kushpet/gnss-fe/README.md

# gnss-fe — смеситель и фильтры к LibreSDR для пары L1/L5

Плата между многочастотной ГНСС-антенной и LibreSDR (AD9363, режим 2R2T): **своя плата v2 (решение 2026-10-28)** — один вход антенны, три выхода, вход гетеродина, вход питания; смеситель переносит L1 на частоту L5 (`docs/03-Плата-v2.md`). Модульный вариант 2026-10-22 (готовые сплиттер и Bias-T, модуль смесителя, фильтры с SMA) — запасной; описание ниже относится к нему. Гетеродин смесителя даёт TX1 того же AD9363, поэтому оба канала когерентны: одна опора, один АЦП, постоянная межканальная задержка. Третий выход сплиттера — HackRF. Смеситель: основной кандидат — модуль HMC213 с AliExpress (пассивный, нужен усилитель гетеродина и МШУ-модуль перед ним), запасной — LTC5510 на своей плате по схеме демоплаты (демоплаты слишком дороги, 2026-10-22).

Узлы — часть исследовательского макета станции ионосферного мониторинга (`~/GitHub/kushpet/iono-gnss`): системные решения, частотный план и конфигурация gnss-sdr — там, в `docs/frontend.md`. Здесь — смеситель и фильтры: требования, компоненты, расчёты, KiCad, измерения.

**Схема A — решение пользователя 2026-10-28**: RX1 — L5 напрямую, RX2 — L1 через фильтр L1 → МШУ SPF5189Z → HMC213 → ФНЧ (`iono-gnss/docs/frontend.md`, разделы 3.8–3.9). Схема B (L1 напрямую, L5 через смеситель) — запасная. Фильтры — готовые модули с SMA с Али; запасной путь — LTCC Mini-Circuits на тестовых платах 1206 с SMA.

```
АНТЕННА ─ кабель ─ Bias-T 5 В ─ сплиттер ─┬─────────────────────────────────────────────────► LibreSDR RX1: L5/E5a/B2a
(МШУ 28–40 дБ)      (готовый)  (готовый)   ├─► ПАВ L1 ─► SPF5189Z ─► HMC213 RF→IF ─► ФНЧ ─────► LibreSDR RX2: L1/E1/B1C
                                           │                            ▲ LO +11…+13 дБм       на 1176.45, спектр инвертирован
                                           │                            └── SPF5189Z ◄── LibreSDR TX1, 2751.87 МГц
                                           └─► третий выход или второй сплиттер в плечо L5 ──► HackRF, во вторую очередь
```

## Состояние

| Этап (нумерация `iono-gnss/docs/frontend.md`) | Что | Статус |
| --- | --- | --- |
| Ф1 | испытания LibreSDR без новых узлов: мощность TX1 на 2.75 ГГц, утечка TX1 в приёмные тракты, паразиты у 1175/1575 МГц, gnss-sdr в 2R2T | не начат |
| Ф3 | схема A (решено 2026-10-28); своя плата v2 — `docs/03-Плата-v2.md` (порты, тракты, бюджет, изготовление, что нужно от пользователя); запасной путь — модуль HMC213 с усилителем гетеродина (или своя плата LTC5510); универсальная плата ПАВ — KiCad, заказ | требования — черновик 2026-10-22 |
| Ф4 | АЧХ узлов петлёй LibreSDR, утечки гетеродина, двухчастотный приём | — |

## Документы

| Файл | Что | Статус |
| --- | --- | --- |
| `docs/01-Требования.md` | состав, плата ПАВ, смеситель, изготовление, открытые вопросы | черновик 2026-10-22 |
| `docs/04-Схема-черновик.md` | черновик схемы платы v2 по блокам: детали, номиналы, выводы, что с ним делать | черновик 2026-10-28 |
| `kicad/` | проект KiCad 10 платы v2 по `docs/04`: листы A–I, свои символы и посадочные места, генератор `kicad/tools/gen_sch.py` | схема-черновик 2026-10-28: нетлист сверен, ERC чистый; разводки нет |
| `docs/03-Плата-v2.md` | своя плата v2: порты, тракты, бюджет шума, LTC5510 или HMC213B, кандидаты, изготовление, этапы | черновик 2026-10-28 |
| `docs/02-Компоненты.md` | демоплаты смесителя, ПАВ, трансформаторы, где купить, что сверить | черновик 2026-10-18, дополнен 2026-10-22 |
| `calc/budget.py` | бюджет шума по трактам (своя плата и готовые модули, схемы A и B), паразитные отклики смесителя | работает: `python3 calc/budget.py` |

**Легенда достоверности** (как в `libresdr-lna`, `qo100-gs`): **[ВД]** паспорт изготовителя · **[ВИ]** вторичный источник (дистрибьютор, карточка магазина) · **[И]** собственное измерение · **[О]** наша оценка или расчёт.
