kushpet/gnss-fe/docs/04-Схема-черновик.md

# Черновик схемы платы v2 (2026-10-28)

Схема по блокам: детали, номиналы, соединения. Основа — `03-Плата-v2.md` и паспорта (LTC5510 rev. A — рис. 1 и 2 и таблицы к ним; BGA524N6 rev. 3.5 — рис. 2, табл. 6; BGA855N6 rev. 2.0 — рис. 2, табл. 6; Mini-Circuits LFCN-1575+, HFCN-2275+). Пометки: [ВД] паспорт, [ВИ] вторичный источник, [О] оценка — подобрать или проверить. Номиналы [О] — предложения, их правим до заказа.

Решения, на которых держится черновик (2026-10-28):

- **Смеситель LTC5510** без усилителя гетеродина: мощность TX1 на 2751.87 МГц около +0.4…+3.4 дБм при полной шкале DDS (`iono-gnss/docs/hardware.md`, «Мощность TX1»), окно LTC5510 −6…+6 дБм [ВД].
- **Питание**: гнездо 5.5 × 2.1 мм, вход 7–12 В (лучше блок 9 В), на плате стабилизаторы 5 В и 2.8 В.
- **Выходы**: OUT1 — L5, OUT2 — L1 на 1176.45 МГц, OUT3 — L2 (ПАВ и МШУ), OUT4 — широкая полоса с делителя (для HackRF на G1, E6/B3, L3OC и для контроля спектра).
- **Сигнальных аттенюаторов нет**; уровни снимает усиление AD9363.

**Проект KiCad** — `kicad/` (2026-10-28): сгенерирован по этому файлу скриптом `kicad/tools/gen_sch.py`, нетлист сверен с задуманными соединениями, ERC — 0 нарушений. Проверено только по паспортам и нетлисту, не в железе. Обозначения ниже совпадают со схемой; поправки 2026-10-28 по паспортам — R6, T2 (C26–C28), FL2.

## Блок A. Питание

| Поз. | Деталь | Номинал, корпус | Соединения | Примечание |
| --- | --- | --- | --- | --- |
| J1 | гнездо питания KLS1-DC-005A-2.0 (Chip-Dip) | на плату, DIP; 30 В 1 А, 5000 циклов, −30…+70 °C [ВД] | вывод 4 — центральный штырь, VIN_RAW (+); 3 — гильза, GND; 2 — переключатель, GND или не подключать | штырь 2.0 мм — под штекеры 5.5 × 2.1 [О]; блок питания с плюсом в центре. Посадочное — своё по чертежу KLS: прорези 3.4 × 0.8 мм под выводы 3 и 4 (через 6 мм по оси), 3.0 × 0.8 мм под вывод 2 (2.5 мм к передней кромке от вывода 4 и 4.8 мм вбок). `BarrelJack_Horizontal` из KiCad почти совпадает, но третий вывод у него сдвинут на 0.5 мм. Центр гнезда — 6.5 мм над платой: отверстие в панели корпуса — на этой высоте |
| D1 | диод Шоттки | 1–3 А, SMA/SMB (класс SS14…SS34) | VIN_RAW → VIN | защита от переполюсовки, падение ~0.4 В [О] |
| F1 | самовосстанавливающийся предохранитель | 0.5 А, 1206 | последовательно с D1 | по желанию [О] |
| U1 | стабилизатор 5 В | ≥ 300 мА, вход до 15 В; кандидаты LM1117-5.0, AMS1117-5.0 или малошумящий | VIN → +5V | с 9 В рассеивает ~0.6 Вт: площадка с медью [О] |
| C1, C2 | 10 мкФ | 0805 | VIN–GND, +5V–GND | по паспорту выбранного U1 |
| FB1, C3, C4 | феррит 600 Ом/100 МГц, 10 мкФ, 100 нФ | 0603, 0805, 0402 | +5V → +5V_MIX | питание LTC5510 |
| FB2, C5, C6 | то же | | +5V → +5V_ANT_IN | питание антенны |
| U2 | малошумящий стабилизатор 2.8 В | ≥ 50 мА; кандидат LP5907MFX-2.8 (есть в библиотеке KiCad) | +5V → +2V8 | МШУ: BGA524N6 1.5–3.3 В, BGA855N6 1.1–3.3 В [ВД] |
| C7, C8 | 1 мкФ | 0402 | вход и выход U2 | по паспорту U2 |
| LED1, R1 | светодиод, 1 кОм | 0603 | +5V–GND | «питание» |

## Блок B. Вход антенны и Bias-T

| Поз. | Деталь | Номинал, корпус | Соединения | Примечание |
| --- | --- | --- | --- | --- |
| J2 | SMA-гнездо торцевое | класс Molex 73251 / Amphenol 132289 (есть в KiCad) | ANT | |
| D2 | защита от статики | ёмкость ≤ 0.3 пФ, рабочее ≥ 5.5 В | ANT–GND | подобрать [О] |
| L1 | дроссель Bias-T | проволочный 0402/0603, 39–56 нГн, резонанс выше 2 ГГц | ANT → ANT_DC | импеданс ≥ 300 Ом на 1.1–1.7 ГГц — сверить по графику [О] |
| C9, C10 | 100 пФ C0G, 10 нФ | 0402 | ANT_DC–GND | развязка по ВЧ со стороны питания |
| U3 | ограничитель тока с флагом аварии | TPS2553DBV, SOT-23-6: 1 IN, 2 GND, 3 EN (активный высокий), 4 ~FAULT (открытый сток), 5 ILIM, 6 OUT [ВД, SLVS841F] | +5V_ANT_IN → ANT_DC; EN — к IN | антенна 15–45 мА; при КЗ в кабеле — ограничение и LED2 |
| R8 | R_ILIM | 210 кОм 1 %, 0402 | ILIM–GND | порог 110/130/150 мА (мин/тип/макс) [ВД, SLVS841F, табл. IOS]; допустимо 15–232 кОм |
| LED2, R2 | светодиод, 1 кОм | 0603 | +5V_ANT_IN → R2 → LED2 → ~FAULT U3 | «авария антенны»: горит, когда U3 тянет флаг к земле |
| C11 | 100 пФ C0G | 0402 | ANT → DIV_IN | разделительный; около 1 ГГц такой конденсатор близок к последовательному резонансу и почти не мешает [О] |
| TP1 | контрольная точка | | ANT_DC | напряжение на антенне |

## Блок C. Делитель 1:2 + 1:2

Три делителя Уилкинсона: DIV_IN → (A, B); A → (P1, P2); B → (P3, P4). Плечи — четвертьволновые линии 70.7 Ом на ~1.38 ГГц (середина 1.17–1.61 ГГц), развязывающий резистор 100 Ом между выходами каждого делителя. На FR4 четверть волны — порядка 30 мм, линии сворачиваются. Геометрию считать в HFSS или openEMS под стек выбранной фабрики [О].

| Поз. | Деталь | Номинал | Примечание |
| --- | --- | --- | --- |
| DIV1, DIV2, DIV3 | делитель Уилкинсона | символ с тремя выводами (IN, O1, O2) | на плате — медь; посадочное место (net tie с геометрией из HFSS/openEMS) пока не назначено |
| R3, R4, R5 | резистор | 100 Ом, 0402, 1 % | по одному на делитель, между O1 и O2 |

Плечи: P1 — тракт L5 (блок D), P2 — тракт L1 (блок E), P3 — тракт L2 (блок F), P4 — OUT4 (блок G). P1 и P2 — с одного делителя, чтобы тракты ядра были симметричны.

## Блок D. Тракт L5 → OUT1

| Поз. | Деталь | Номинал, корпус | Соединения | Примечание |
| --- | --- | --- | --- | --- |
| R9 | перемычка | 0 Ом, 0402 | P1 → L5_IN | мерить узлы по отдельности |
| FL1 | ПАВ L5 | Huaying NDFH059-1176SA (1.1 × 0.9 мм, LCSC C5158023): потери ≤ 1.6 дБ в 1166–1187 МГц; 1 — вход, 4 — выход, 2, 3, 5 — земля [ВД]; запасные Qorvo QPQ1062, Abracon AFII-SW-0060 | L5_IN → L5_SAW | рекомендованного посадочного в паспорте нет — своё по чертежу корпуса, сверить [О]; земли — переходными отверстиями прямо у площадок |
| L2 | индуктивность согласования | 9.4 нГн, 0402, Murata LQW15 | L5_SAW → AI (5) U4 | [ВД, BGA855N6, табл. 6] |
| U4 | BGA855N6 | TSNP-6-10 | 1, 4 — GND; 2 — +2V8; 3 — AO → L5_LNA; 5 — AI; 6 — PON → +2V8 | [ВД] |
| C12 | ≥ 1 нФ | 0402 | +2V8–GND у вывода 2 | ВЧ-развязка [ВД] |
| C13 | 100 пФ C0G | 0402 | L5_LNA → J3 | разделительный [О] |
| J3 | SMA торцевое | | OUT1 → LibreSDR RX1 | |

Разделительный 1 нФ на входе МШУ (C1 в паспорте) не нужен: постоянный ток не проходит через ПАВ [ВД, сноска к табл. 6 BGA524N6].

## Блок E. Тракт L1 → смеситель → OUT2

| Поз. | Деталь | Номинал, корпус | Соединения | Примечание |
| --- | --- | --- | --- | --- |
| R10 | перемычка | 0 Ом, 0402 | P2 → L1_IN | мерить узлы по отдельности |
| FL2 | ПАВ L1 широкий | нужно: полоса не уже 1563–1588 МГц, ≥ 30 дБ на 1164–1189 МГц. В схеме — Huaying NDFH003-1580SA (LCSC C312141): потери ≤ 1.6–2.1 дБ в 1559–1606 МГц, выводы как у FL1 [ВД]; запасной Murata SAFFB1G56KB0F0A (1559–1606) | L1_IN → L1_SAW | **подавление NDFH003 в 960–1427 МГц, то есть на L5, в паспорте не задано**: таблица — ≥ 45 дБ до 925 МГц и ≥ 41 дБ в 1427–1453 МГц, график — только 1455–1705 МГц. Замерить петлёй до заказа плат [О] |
| L3 | индуктивность согласования | 8.2 нГн, 0402, Murata LQW | L1_SAW → AI (5) U5 | [ВД, BGA524N6, табл. 6] |
| U5 | BGA524N6 | TSNP-6-10 | 1, 4 — GND; 2 — +2V8; 3 — AO → L1_LNA; 5 — AI; 6 — PON → +2V8 | [ВД] |
| C14 | 1 мкФ (≥ 10 нФ) | 0402 | +2V8–GND у вывода 2 | [ВД] |
| R11 | перемычка | 0 Ом, 0402 | L1_LNA → MIX_IN (T1) | мерить МШУ и смеситель по отдельности |
| U6 | LTC5510 | QFN-16 4 × 4 мм (UF16), шаг 0.65 мм, площадка снизу 2.15 × 2.15 мм — земля [ВД, стр. 28]; посадочное `QFN-16-1EP_4x4mm_P0.65mm_EP2.15x2.15mm_ThermalVias` из KiCad | см. ниже | [ВД] |
| FL3 | ФНЧ LFCN-1575+ | FV1206 | IF_OUT → IF_LPF | DC–1575 МГц, 37 дБ на 2700 МГц [ВД] |
| C15 | 100 пФ C0G | 0402 | IF_LPF → J4 | |
| J4 | SMA торцевое | | OUT2 → LibreSDR RX2 | |

Выводы U6 [ВД, паспорт LTC5510, Pin Functions] и обвязка:

| Вывод | Куда | Детали |
| --- | --- | --- |
| 1 TEMP | контрольная точка TP2 | диод на кристалле через 30 Ом — по нему можно мерить температуру смесителя (уход DCB) |
| 2 IN+, 3 IN− | вторичная обмотка T1 через C16, C17 | T1 — TC1-1-13M+ (1:1), первичная — L1_LNA и земля; C16, C17 — 0.1 мкФ 0402; C18 — 0.7 пФ C0G на входе, как на DC1983A (рис. 1) |
| 4 LGND | GND через L4 | L4 — 0 Ом 0603 (рис. 1); ток ~64 мА |
| 5 EN | +5V_MIX | включено при > 1.8 В |
| 6, 7 VCC1, VCC2 | +5V_MIX | C19 — 10 нФ у выводов, C20 — 1 мкФ 0603 |
| 8 IADJ | R6 не ставится | **поправка 2026-10-28**: по табл. 7 паспорта при 5 В и fOUT < 1200 МГц IADJ открыт (ICC 105 мА); 4.75 кОм — для fOUT > 1200 МГц. На DC1984A R1 тоже не стоит [ВД]. Место R6 (0402 на GND) оставлено для подбора |
| 9, 12, 13, 17 GND | земля | площадка снизу — много переходных отверстий |
| 10 OUT−, 11 OUT+ | T2 — TC4-19LN+ (4:1), AT224-1A | по рис. 2 (DC1984A) [ВД]: OUT+ → L5 15 нГн → T2 вывод 3, OUT− → L6 15 нГн → T2 вывод 1 (вторичная, 200 Ом); средний отвод T2 (вывод 2) — к +5V_MIX, C26 10 нФ у вывода (C8 на DC1984A); питание выходов ~32 мА на вывод. Первичная: вывод 6 → C27 10 нФ → FL3, вывод 4 → C28 10 нФ → земля — у TC4-19LN+ обмотки соединены по постоянному току, на обоих концах первичной нужны разделительные конденсаторы [ВД, паспорт TC4-19LN+]. Вывода 5 у TC4-19LN+ нет |
| 14 LO− | GND через C21 | C21 — 0.1 мкФ 0402: гетеродин несимметричный |
| 15 LO+ | от блока H через C22 | C22 — 0.1 мкФ 0402 |
| 16 TP | GND | обязательно [ВД] |

**Главный риск схемы**: выход на 1176 МГц. DC1984A в паспорте охарактеризована с выходом 100–1000 МГц, а DC1983A — с выходом 1575 МГц (балун BD1222J50200AHF, 6.8 нГн × 2, 6.8 пФ). 1176 МГц лежит между ними. Выход LTC5510 — 201 Ом || 0.6 пФ дифференциально на 1500 МГц [ВД]; 0.6 пФ на 1176 МГц — 225 Ом, то есть ёмкость уже сравнима с нагрузкой. Предложение [О]: обвязка DC1984A (TC4-19LN+, L5 и L6 по 15 нГн) и места под подбор:
- **L8, L9** (0603, не ставятся) — от OUT+ и OUT− к +5V_MIX, как L1 и L2 на DC1984A. Резонанс с 0.6 пФ на 1176 МГц даёт ~30 нГн дифференциально, то есть ~15 нГн на плечо [О];
- **C29** (0402, не ставится) — параллельно первичной обмотке T2;
- **L5, L6** — 0402, номинал подбирается.

Подбирать по максимуму S21 петлёй LibreSDR на 1176 МГц.

## Блок F. Тракт L2 → OUT3

| Поз. | Деталь | Номинал, корпус | Соединения | Примечание |
| --- | --- | --- | --- | --- |
| FL4 | ПАВ L2 | кандидаты Qorvo QPQ1061 (1227.6 МГц, 31 МГц, 1.4 × 1.2 мм), Microchip TFS1227K (24 МГц, 1.4 × 1.1 мм) | P3 → L2_SAW | ГЛОНАСС G2 (1243–1249 МГц) у найденных не покрыт или покрыт краем; G2 — через OUT4 [ВИ] |
| L7, U7, C23 | как L2, U4, C12 в блоке D | BGA855N6 работает на 1164–1300 МГц [ВД] | L2_SAW → U7 → L2_LNA | |
| C24 | 100 пФ C0G | 0402 | L2_LNA → J5 | **обязателен**: HackRF может подать на порт 3.3 В |
| J5 | SMA торцевое | | OUT3 → HackRF | |

## Блок G. OUT4 — широкая полоса

| Поз. | Деталь | Номинал | Соединения | Примечание |
| --- | --- | --- | --- | --- |
| C25 | 100 пФ C0G | 0402 | P4 → OUT4 | разделительный |
| J6 | SMA торцевое | | OUT4 | |
| R7 | 49.9 Ом | 0402, по желанию | P4–GND | ставится вместо J6, если выход не нужен; неподключённый выход закрывать нагрузкой 50 Ом |

## Блок H. Гетеродин

| Поз. | Деталь | Номинал, корпус | Соединения | Примечание |
| --- | --- | --- | --- | --- |
| J7 | SMA торцевое | | LO ← LibreSDR TX1 | |
| FL5 | ФВЧ HFCN-2275+ | FV1206: 1 — вход, 3 — выход, 2, 4 — земля [ВД] | J7 → LO_HPF → C22 → LO+ U6 | давит шум TX в L-диапазоне: ≥ 40 дБ (тип. 45) на 1400 МГц [ВД] |

Уровень гетеродина задаётся программно (`lo_attenuation_db` в gnss-sdr); при оценке TX1 +0.4…+3.4 дБм и потерях ФВЧ ~1 дБ — начать с 0 дБ.

## Блок I. Конструкция

- Экран-рамка SH1 на плате над U6, T1, T2 и трактом гетеродина. В схеме стоит Laird BMI-S-203-F (26 × 26 мм) из `RF_Shielding`; размер подобрать по разводке [О].
- Плата — 4 слоя, 1.6 мм; второй слой — сплошная земля; копланарные линии 50 Ом с землёй; переходные отверстия вдоль линий и у земляных площадок ПАВ и МШУ.
- Все SMA — торцевые, на двух кромках: ANT, LO и питание — на одной, OUT1–OUT4 — на другой.
- Последовательные 0 Ом между блоками C–D (R9), C–E (R10), E (U5 → T1, R11), чтобы мерить узлы по отдельности.

## Проект KiCad (`kicad/`)

| Файл | Что |
| --- | --- |
| `gnss-fe.kicad_pro`, `gnss-fe.kicad_sch` | проект и корневой лист — структура платы |
| `A_power` … `I_mech.kicad_sch` | листы блоков A–I этого файла |
| `gnss-fe.kicad_sym` | свои символы: LTC5510, BGA524N6, BGA855N6, ПАВ (5 выводов, нумерация Huaying), HFCN-2275+, TC4-19LN+, TPS2553DBV, KLS1-DC-005A, делитель Уилкинсона, экран, цепи +5V_MIX и +5V_ANT_IN |
| `gnss-fe.pretty` | свои посадочные: TSNP-6-10 (рис. 6–7 паспорта BGA524N6 [ВД]), ПАВ Huaying 1.1 × 0.9 мм (по чертежу корпуса [О]), KLS1-DC-005A (по чертежу KLS [ВД], кольцо площадок [О]) |
| `tools/gen_sch.py`, `kisch.py`, `gen_lib.py` | генератор: `python3 kicad/tools/gen_sch.py --force`; после правок в KiCad не запускать — перезапишет |

Не назначены посадочные: DIV1–DIV3 (медь делителя — после расчёта под стек) и FL4 (ПАВ L2 не выбран). Перед разводкой у FL4 сверить нумерацию выводов. ERC в KiCad чистый, если в KiCad настроены стандартные библиотеки.

## Что с этим делать

1. **Открыть `kicad/gnss-fe.kicad_pro` и прочитать листы.** Всё, что не нравится или непонятно, — сюда, в этот файл или вопросом.
2. **Решить по открытым пунктам**: ПАВ L1 (подавление NDFH003 на L5 не нормировано), ПАВ L2, D2, U1 и его выходной конденсатор, L1, размер экрана.
3. **Параллельно**: выбрать продавца плат на Али и спросить у него стек 4-слойной платы 1.6 мм (толщины слоёв и εr). Под этот стек — ширина линий 50 и 70.7 Ом и модель делителя в HFSS.
4. **Потом** — BOM с источниками (Chip-Dip, Али, LCSC) и ценой, разводка.
