kushpet/gnss-fe/correspondence/rezonit/2026-11-08-письмо.md

# Письмо в Резонит — стек и заказ прототипа

- **Дата:** 2026-11-08
- **Кому:** pcb@rezonit.ru (ООО «Резонит», 8 800 777-80-80)
- **Статус:** отправлено 2026-11-08

> Внимание: правильный домен — **rezonit.ru** (буква z). Если письмо ушло на
> «resonit.ru» — это опечатка, отправить повторно на pcb@rezonit.ru.

---

Здравствуйте.

Разрабатываю прототип СВЧ-платы (фронтенд ГНСС-приёмника, рабочая полоса
~1,1–1,6 ГГц) и хочу заказать у вас плату с трафаретом:

— 4 слоя, толщина 1,6 мм, FR4;
— размер ~100 × 80 мм;
— 5 шт. + трафарет;
— управляемое сопротивление: копланарные линии 50 Ом, плечи делителя 70,7 Ом.

Вопросы:

1. Какой у вас стандартный стек 4-слойной платы 1,6 мм? Нужны точные толщины
   препрегов и ядра, толщина меди и диэлектрическая проницаемость εr (и её
   допуск) — по ним я посчитаю ширину линий 50 и 70,7 Ом. Если есть готовый
   стек под управляемое сопротивление — пришлите, пожалуйста.

2. Принимаете ли Gerber RS-274X + Excellon (экспорт из KiCad)? Есть ли
   требования к именам файлов, контуру, панелизации?

3. Какая цена и срок на 5 шт. (4 слоя, 100 × 80 мм) + трафарет?

4. Есть ли онлайн-калькулятор импеданса или тестовый купон для контроля 50 Ом?

Заранее спасибо.
