kushpet/gnss-fe/docs/03-Плата-v2.md

# Плата v2: один вход, три выхода (решение 2026-10-28)

Решение пользователя 2026-10-28: вместо россыпи модулей на столе — своя плата в корпусе. Один вход антенны, три выхода, вход гетеродина и вход питания. Срок не горит: разработка постепенно, сборка, возможно, на рабочем месте. Схема каналов — A (решение 2026-10-28, `iono-gnss/docs/frontend.md`, раздел 3.8). За основу взят черновик 2026-10-18 (в истории git, `ec24c67:docs/01-Требования.md`). Пометки: [ВД] паспорт, [ВИ] вторичный источник, [И] измерение, [О] оценка.

## 1. Порты

| Порт | Куда | Сигнал | Требования |
| --- | --- | --- | --- |
| ANT | антенна с МШУ 28–40 дБ, кабель ~5 м | 1164–1610 МГц | SMA-гнездо; Bias-T 5 В с ограничением тока и индикацией; защита от статики малой ёмкости |
| OUT1 | LibreSDR RX1, RX-гетеродин 1176.45 МГц | L5/E5a/B2a | разделительный конденсатор |
| OUT2 | LibreSDR RX2 | L1/E1/B1C, перенесённый на 1176.45 МГц, спектр инвертирован | то же |
| OUT3 | HackRF | L2 (GPS L2C; ПАВ и МШУ) — «полный вариант», ответ 2026-10-28 | разделительный конденсатор обязателен: HackRF может подать на порт 3.3 В |
| OUT4 | HackRF или контроль спектра | широкая полоса с делителя: ГЛОНАСС G1 и G2, E6/B3, L3OC | SMA; неподключённый — закрыть нагрузкой 50 Ом |
| LO | LibreSDR TX1 | 2751.87 МГц, тон DDS | ФВЧ против шума TX в L-диапазоне; уровень — программно (`lo_attenuation_db`) |
| PWR | 7–12 В, гнездо 5.5 × 2.1 мм (ответ 2026-10-28; блок 9 В) | — | ~200 мА [О]; защита от переполюсовки; стабилизаторы 5 В и 2.8 В, LC-фильтры |

## 2. Тракты (схема A)

```
ANT ─ Bias-T, защита ─ делитель 1:2 + 1:2 ─┬─ ПАВ L5 ─ МШУ L5 ─────────────────────────── OUT1 → LibreSDR RX1
                                           ├─ ПАВ L1 ─ МШУ L1 ─ смеситель RF→IF ─ ФНЧ ──── OUT2 → LibreSDR RX2
                                           │                         ▲ LO
                                           │            LO (SMA) ─ ФВЧ (с LTC5510 усилитель гетеродина не нужен)
                                           ├─ ПАВ L2 ─ МШУ L2 ──────────────────────────── OUT3 → HackRF
                                           └─ OUT4: широкая полоса (или нагрузка 50 Ом)
```

Бюджет шума [О, `calc/budget.py`, блок «Своя плата v2»; кабель 5 м RG58]:

| Тракт | Потеря C/N0, антенна 28 / 40 дБ | Усиление до LibreSDR | Шум тракта над шумом LibreSDR |
| --- | --- | --- | --- |
| OUT1: ПАВ L5, BGA855N6 | 0.1 / 0.0 дБ | 34 / 46 дБ | +27 / +39 дБ |
| OUT2: ПАВ L1, BGA524N6, LTC5510, ФНЧ | 0.2 / 0.0 дБ | 36 / 48 дБ | +29 / +40 дБ |
| OUT2: ПАВ L1, BGA524N6, HMC213B, ФНЧ | 0.2 / 0.0 дБ | 24 / 36 дБ | +17 / +29 дБ |

- **Усилители на плате делают тракт независимым от антенны**: при 28 и при 40 дБ потери не больше 0.2 дБ. Делитель 1:2 + 1:2 (~7 дБ) стоит до усилителей и почти ничего не стоит по шуму.
- **Аттенюаторов в сигнальных трактах нет.** Лишнее усиление снимает усиление самого AD9363; шум тракта на 17–40 дБ выше собственного шума LibreSDR, и его паразиты тонут.
- **ПАВ — до усилителя платы**: широкополосный усилитель без фильтра не ставим.
- После HMC213B усилитель ПЧ не нужен: без него потеря 0.2 дБ.
- **Экран-рамка** над смесителем и трактом гетеродина; плата — в алюминиевом корпусе.
- По желанию — датчик температуры рядом с трактами: уход разности задержек L1/L5 даёт уход DCB приёмника.

## 3. Смеситель: LTC5510 или HMC213B

| | LTC5510 | HMC213B |
| --- | --- | --- |
| Тип | активный, 5 В, ~100 мА [ВД] | пассивный, диоды Шоттки, без питания [ВД] |
| Гетеродин | −6…+6 дБм — прямо от TX1 [ВД] | +9…+15 дБм — нужен усилитель гетеродина на плате [ВД] |
| Обвязка | трансформаторы на входе и выходе: TC1-1-13M+ и TC4-19LN+ с 15 нГн × 2, как на DC1984A; выход 10–1300 МГц, на 1176 МГц не характеризован [ВД] | порты 50 Ом, согласование не нужно; IF открыт по постоянному току [ВД] |
| Развязки | лучше: утечка гетеродина на выход < −33 дБм, вход → выход > 22 дБ [ВД] | утечки гетеродина −17…−19 дБм с портов, RF → IF 13 дБ [ВД] |
| Корпус | QFN-16 4 × 4 мм с площадкой — паста и фен или фабрика | MSOP-8 — паяльником |
| LCSC (снимки страниц, 2026-10-28) [ВИ] | LTC5510IUF#PBF C459909: 22 шт., ~$23 | HMC213BMS8E C3191301: нет на складе, ~$20 |

**Решено 2026-10-28 по замеру: LTC5510** без усилителя гетеродина. TX1 на 2751.87 МГц даёт около +0.4…+3.4 дБм при полной шкале DDS (±3 дБ; `iono-gnss/docs/hardware.md`, «Мощность TX1») — в окне LTC5510 −6…+6 дБм. HMC213B — запасной путь (нужен усилитель гетеродина на ~12 дБ).

## 4. Компоненты-кандидаты

Сверить паспорта и наличие при составлении BOM. Подробнее — `02-Компоненты.md`.

| Узел | Кандидаты |
| --- | --- |
| МШУ L1 | Infineon BGA524N6: 1550–1615 МГц, 19.6 дБ, Кш 0.73 дБ на 2.8 В (плата Infineon), LCSC C6752883 [ВИ] |
| МШУ L5 и OUT3 | Infineon BGA855N6: 1164–1300 МГц, 17.8 дБ, Кш 0.6 дБ [ВД]; для OUT3 на L1/G1 — BGA524N6 |
| ПАВ L1/G1 | Murata SAFFB1G56KB0F0A (1559–1606 МГц) [ВИ]; Qualcomm B39162B4300F210 — LCSC C2650962, полосу проверить: в семействе B39162 есть фильтры на 2 МГц, только для C/A [ВИ] |
| ПАВ L5 | Huaying NDFH059-1176SA (LCSC C5158023), Qorvo QPQ1062, Abracon AFII-SW-0060 [ВИ] |
| ФНЧ после смесителя | Mini-Circuits LFCN-1575+ или LFCG-1575+ (LCSC C4989936) [ВД, ВИ] |
| ФВЧ гетеродина | Mini-Circuits HFCN-2275+ [ВД] |
| Делитель | Уилкинсон на линиях 1:2 + 1:2, моделирование в HFSS или openEMS; запасной путь — готовый делитель в корпусе (не искали) |
| Bias-T, питание | дроссель с резонансом выше 2 ГГц, ограничитель тока антенны с флагом аварии, стабилизатор 3.3 В для МШУ (BGA855N6 — не выше 3.3 В [ВД]), 5 В для LTC5510 — подобрать |

## 5. Изготовление

- **Плата**: 4 слоя, 1.6 мм; под ВЧ-слоем сплошная земля на втором слое; копланарная линия 50 Ом с землёй и частыми переходными отверстиями; ширину линии считать по стеку выбранной фабрики [О].
- **Китайские фабрики напрямую**: JLCPCB перестала принимать оплату и отправлять в Россию в марте 2022 года, PCBWay — в апреле 2022 года (по данным посредника pcbchina.ru) [ВИ]. На странице JLCPCB сказано только «в большинство стран», без списка [ВИ, обновлена 2026-09-09].
- **Посредники** [ВИ, поиск 2026-10-28]: JLCPOST — платы JLCPCB от 1100 ₽ за 5 шт. (2 слоя, 100 × 100 мм), 3–6 недель, СДЭК и Почта России; монтаж не заявлен. «Соболь Электроникс» (sobol-e.ru) — платы, а с октября 2025 года, по их словам, и сборка на фабрике. Российские фабрики (Резонит, Матрикс) — дороже.
- **Через AliExpress** продавцы «PCB и PCBA на заказ» есть, но их процесс и качество не проверить; для первой ВЧ-платы не советую [О].
- **Монтаж на фабрике** для этой платы [О]: ВЧ-детали на LCSC то появляются, то пропадают; за 2–5 плат — плата за подготовку линии; первую ВЧ-плату всё равно придётся дорабатывать по замерам. Предложение: голые платы и трафарет через посредника, детали — LCSC, Chip-Dip; пайка на работе или дома феном с трафаретом. В BOM сразу ставить номера LCSC — тогда фабричный монтаж останется возможным для следующих экземпляров.
- **Проверка по частям**: между узлами — последовательные 0 Ом, чтобы мерить каждый узел петлёй LibreSDR (`sweep`); векторный анализатор, если найдётся на работе.

## 6. Ответы пользователя (2026-10-28) и что осталось

| Вопрос | Ответ |
| --- | --- |
| Мощность TX1 | петля TX1A → 30 дБ → RX1A есть; замер 2026-10-28 — +0.4…+3.4 дБм (±3), выбран LTC5510 |
| Корпус | алюминиевая коробка подходящего размера с Али или из Chip-Dip — подобрать после разводки, ориентир внутри ~100 × 80 × 25 мм с пазами под плату [О] |
| Питание | гнездо KLS1-DC-005A-2.0 на плату (5.5 × 2.1 мм, 30 В 1 А), вход 7–12 В (а не USB-C: на USB только 5 В — у стабилизатора 5 В нет запаса, а зарядники шумят) |
| Изготовление | плата на AliExpress, детали россыпью, пайка своими руками; ориентир $100, если не входим — пересмотреть |
| Схема | начать с черновика отсюда: `04-Схема-черновик.md` |
| OUT3 | сразу «полный вариант»: OUT3 — L2 с ПАВ и МШУ, плюс OUT4 — широкая полоса |
| Антенна | для первых опытов — TAN1216Q50A (28 дБ) |

**Бюджет** [О, цены ориентировочные; точно — в BOM]: плата 4 слоя ~100 × 80 мм, 5 шт., с трафаретом — $25–50; LTC5510 — ~$10–25 (LCSC ~$23, на Али дешевле, но риск подделки); трансформаторы TC1-1-13M+ и TC4-19LN+ — $5–15; МШУ BGA524N6 и BGA855N6 с запасом — $5–10; ПАВ L1, L5, L2 с запасом — $5–15; LFCN-1575+ и HFCN-2275+ — $5–10; SMA торцевые × 7 — $5–10; питание, защита, мелочь — $5–10; корпус — $10–15. **Итого ~$80–160**: в $100 входим только при дешёвой плате и LTC5510 с Али. Резерв экономии — не ставить тракт OUT3 в первой сборке (места на плате остаются).

## 7. Этапы

| № | Что | Кто |
| --- | --- | --- |
| 1 | Замеры Ф1 на LibreSDR без платы: мощность TX1, паразиты у 1175.02 МГц, утечка TX1 в приёмники | пользователь |
| 2 | BOM v2 с номерами LCSC и Chip-Dip, наличие, бюджет | здесь |
| 3 | Схема в KiCad | пользователь, проверка здесь |
| 4 | Делитель и переходы — моделирование; стек под фабрику | пользователь (HFSS) |
| 5 | Разводка, DRC, заказ плат и трафарета | пользователь |
| 6 | Сборка, включение по узлам, замеры петлёй LibreSDR | пользователь |

Модули с Али из `~/Downloads/iono/` (2026-10-28) пригодятся как эталоны при проверке платы, покупать их не обязательно: ПАВ L1 FBP-1590s (HESUI) — по графику продавца полоса 1549–1611 МГц по −3 дБ, потери 1.7 дБ на 1585 МГц; на 1.17 ГГц около −37 дБ, на 2.75 ГГц около −40 дБ (по графику, на глаз) [ВИ]; ФНЧ Mini-Circuits VLF-1500+ — DC–1500 МГц, 0.67 дБ на 1500 МГц, 31–35 дБ на 2.15–3 ГГц [ВД, паспорт на картинке]; модуль HMC213 (HESUI) — плата с экраном, три SMA [ВИ].
