kushpet/gnss-fe/docs/01-Требования.md

# Требования к смесителю и плате фильтров (черновик, 2026-10-22)

**С 2026-10-28 основной путь — своя плата v2, `03-Плата-v2.md`.** Этот документ описывает модульный вариант; он остаётся запасным.

Исходные решения — `iono-gnss/docs/frontend.md`, разделы 1 и 3.6–3.8: три канала SDR, сплиттер и Bias-T готовые, своё — смеситель и фильтры; верхний гетеродин 2751.87 МГц от TX1. Черновик 2026-10-18 (плата фронтенда целиком: Bias-T, делитель, МШУ, смеситель, экран) снят — он в истории git. Пометки: [ВД] паспорт, [ВИ] вторичный источник, [И] измерение, [О] оценка.

## 1. Состав

| Узел | Что | Откуда |
| --- | --- | --- |
| Bias-T, МШУ | 5 В на антенну, до сплиттера; МШУ — модуль SPF5189Z после ПАВ L1 перед смесителем | есть у пользователя |
| Усилитель гетеродина | второй модуль SPF5189Z: P1dB +22.3…+22.7 дБм, OIP3 +39.5 дБм, вход до +27 дБм [ВД, DS110606]; на 2.75 ГГц ожидаем 9–10 дБ [О] | AliExpress |
| Сплиттер 1→3 | 1.1–1.7 ГГц, SMA; кандидат XINQY XQY-PS3-1.1/1.7-SE (~$40, `iono-gnss/docs/plan.md`) | AliExpress |
| Фильтры | **первая фаза — готовые модули с SMA с Али**: ПАВ L1 (`1550-1610MHz SAW bandpass … SMA`) перед смесителем, ФНЧ `DC-1500MHz LPF … SMA` после (требования и проверка — `iono-gnss/docs/frontend.md`, раздел 3.9). Запасной путь — **LTCC Mini-Circuits на готовых тестовых платах 1206 с SMA** (2026-10-22): схема A — BFCN-1575+ перед смесителем, LFCN-1575+ после, HFCN-2275+ в тракте гетеродина (по желанию); своя плата ПАВ (раздел 2) — только если тестовые платы не подойдут | AliExpress, LCSC, Chip-Dip |
| Смеситель | **основной кандидат — модуль HMC213 с SMA** (~$18–20, раздел 3.1); запасной — LTC5510 на своей плате по схеме демоплаты (раздел 3.2). Демоплаты DC1983A/DC1984A пользователь счёл слишком дорогими (2026-10-22) | AliExpress / своя |
| Гетеродин | с HMC213: TX1 → усилитель-модуль (класс SPF5189Z) → [фильтр 2.75 ГГц] → LO, нужно +11…+13 дБм; с LTC5510: TX1 → кабель (→ аттенюатор, если TX1 сильнее +6 дБм) → LO | AliExpress |
| МШУ | с HMC213 — один МШУ-модуль после ПАВ перед смесителем (без него −1.6 дБ C/N0 при антенне 36 дБ, запас шума над LibreSDR 5–9 дБ); с LTC5510 при антенне 38 ± 2 дБ не нужен [О, `calc/budget.py`] | AliExpress |

Порядок фильтров у смесителя: в схеме A — полосовой L1 (BFCN-1575+) перед, ФНЧ (LFCN-1575+) после; в схеме B — полосовой L5 перед, L1 или ФНЧ после. С HMC213 и LTCC выгоднее A (`iono-gnss/docs/frontend.md`, разделы 3.8–3.9): фильтру перед смесителем нужно ≥ 30 дБ на второй полосе ГНСС (у HMC213 развязка RF → IF 13 дБ, мин. 8 [ВД]), у BFCN-1575+ на 1150 МГц — 47 дБ [ВД]; готового полосового L5 с таким подавлением нет. Зачем оба — `iono-gnss/docs/frontend.md`, раздел 3.6. Коротко: перед смесителем — против откликов от сотовой связи и ТВ и против прямого прохода второй полосы ГНСС (развязка вход → выход LTC5510 > 22 дБ на 1150–3000 МГц [ВД]); после — против утечки гетеродина на выход (< −33 дБм [ВД]).

## 2. Плата ПАВ (запасной путь)

Нужна, только если тестовые платы LTCC с Али не подойдут или понадобятся ПАВ (полосы L2, G1 для HackRF).

- **Цепь:** SMA — место под разделительный конденсатор (по умолчанию перемычка 0 Ом) — место под П-аттенюатор 0603 (по умолчанию 0 Ом последовательно, параллельные не ставить) — ПАВ — SMA. Постоянного тока на выходах сплиттера нет (Bias-T до него), конденсатор — на случай, если на порт приёмника подадут питание антенны.
- **Одна разводка на все полосы:** ПАВ L1, L5, L2 (и, может быть, G1) подобрать в одном корпусе; если не выйдет — 2–3 варианта посадочного места на одной панели [О]. Кандидаты — `02-Компоненты.md`.
- **Линии:** копланарная линия 50 Ом с землёй, сплошная земля снизу, частые переходные отверстия вдоль линии и прямо у площадок земли ПАВ. Подавление ПАВ вне полосы (35–40 дБ) держится только при малой индуктивности земли: 1 нГн — это ≈ 10 Ом на 1.6 ГГц [О].
- **Разъёмы:** торцевые SMA-гнёзда.
- **Проверка:** S21 петлёй LibreSDR (`sweep`) в 1.0–3.0 ГГц: потери в полосе; подавление на второй полосе ГНСС (1176 или 1575 МГц), на гетеродине 2752 МГц и на UMTS 1964/2164 МГц.

## 3. Смеситель

### 3.1. Модуль HMC213 (основной кандидат, 2026-10-22)

- **Паспорт HMC213B** [ВД]: RF и гетеродин 1.5–4.5 ГГц, ПЧ 0–1.5 ГГц; гетеродин +9…+15 дБм (+13 тип.); потери 10 дБ, на ПЧ 1.2 ГГц при гетеродине +13 дБм ~10.5 дБ, при +11 ~11.5, при +9 ~15 (рис. 56, 58); IIP3 21 дБм; развязки RF → IF 13 дБ (мин. 8), гетеродин → RF 32 дБ, гетеродин → IF 30 дБ.
- **Подключение (схема A, решение 2026-10-28):** L1 на RF, выход 1176 МГц с IF. В запасной схеме B — L5 на порт IF, выход 1575 МГц с порта RF (пассивный смеситель обратим; паспорт даёт и режим повышающего преобразования). Без питания; порт IF открыт по постоянному току (≤ 9 мА), предел RF и IF +13 дБм, LO +27 дБм [ВД]. RF 1575 МГц — у нижней границы диапазона 1.5 ГГц.
- **Утечки:** гетеродин +13 дБм → около −17…−19 дБм на обоих сигнальных портах. ПАВ до и после смесителя должны давить 2.75 ГГц на ≥ 35 дБ; проверить петлёй (`sweep` до 3 ГГц).
- **Проверка модуля при получении:** потери преобразования петлёй LibreSDR (TX2 как сигнал, TX1 через усилитель как гетеродин) против паспорта — модуль китайский, микросхема может быть перемаркированной или старой HMC213 вместо HMC213B.

### 3.2. LTC5510 (запасной путь)

- **Порты** [ВД, паспорт rev. A и демо-мануал DC1983A]: вход 30–3000 МГц, согласован на 50 Ом, трансформатор 1:1 TC1-1-13M+; гетеродин 5–6000 МГц, −6…+6 дБм, несимметричный, 50 Ом; выход — открытые коллекторы, 245 Ом дифференциально с ёмкостью ~0.6 пФ, сводится трансформатором или балуном.
- **Выход под схему B (1575 МГц), как на DC1983A:** L1, L2 = 6.8 нГн, C9 = 6.8 пФ, балун Anaren BD1222J50200AHF; возвратные потери ≥ 12 дБ в 1.2–2.1 ГГц [ВД]. Характеризовано при выходе 1575 МГц: усиление 1.1–1.5 дБ, Кш 11.6–12.1 дБ, OIP3 24.5–27.8 дБм [ВД].
- **Выход под схему A (1176 МГц), как на DC1984A:** L4, L5 = 15 нГн, трансформатор TC4-19LN+; возвратные потери ≥ 12 дБ в 10–1300 МГц [ВД]. Усиление и Кш при выходе 1176 МГц в паспорте не приведены.
- **Питание:** 5 В (4.5–5.3 В), ~100 мА; нарастание питания не быстрее 1 мс — иначе выброс через внутреннюю защиту [ВД]. Вход EN (> 1.8 В — включено).
- **Своя плата** (если демоплату не купить): повторить схему и разводку демоплаты — ADI выкладывает её файлы [ВД, демо-мануал]. Их подложка — Nelco N4000-13, 0.015″ до земли [ВД]; на FR4 пересчитать ширину линий. QFN-16 4 × 4 мм с площадкой под корпусом, вывод LGND — прямо на землю [ВД]. Металлическая крышка или коробка — по замеру утечки гетеродина [О].

## 4. Изготовление и сборка

- **Бюджет — до $100** на смеситель и платы ПАВ (антенна и сплиттер — из отдельного лимита). Демоплата DC1983A (DigiKey €132 [ВИ]) в него не помещается; модуль HMC213 (~$18–20 [ВИ]) с усилителем и МШУ-модулями — помещается [О].
- **Макетки под корпуса — нет** (`iono-gnss/docs/frontend.md`, раздел 3.7): ПАВ с площадками под корпусом на переходник не поставить, у QFN земля под корпусом. «Макетка» для СВЧ — маленькая плата с копланарной линией и SMA, то есть плата ПАВ.
- **Фабрика.** JLCPCB, скорее всего, недоступен. Сравнить: российские фабрики и заказ плат через AliExpress; 2 слоя против 4 по цене. Вместе с платой — трафарет, если фабрика делает.
- **Сборка — фен.** ПАВ 1.1 × 0.9…1.4 × 1.2 мм; пассивные компоненты 0603. Сначала потренироваться на пробной плате.
- **Без подстройки.** Векторного анализатора нет, меряем петлёй LibreSDR (S21, скалярно). Поэтому — готовые ПАВ и схема смесителя из паспорта.

## 5. Что такое трафарет

Тонкая (0.1–0.12 мм) стальная или плёночная пластина с окнами точно над площадками платы; её делают по тем же файлам, что и плату (слой паяльной пасты). Плату фиксируют, сверху кладут трафарет и шпателем проводят паяльную пасту — она остаётся одинаковыми дозами только на площадках. Затем пинцетом ставят компоненты и прогревают феном (лучше с нижним подогревом плиткой). Для корпусов ~1 мм с площадками под корпусом это надёжнее пасты из шприца: меньше перемычек и «непропаев» [О, общая практика].

## 6. Открытые вопросы

1. ~~Схема A или B~~ — **A** (решение пользователя 2026-10-28; `iono-gnss/docs/frontend.md`, раздел 3.8).
2. **Смеситель:** модуль HMC213 + усилитель гетеродина + МШУ-модуль (решить, заказывать ли); запасной — своя плата LTC5510 (LTC5510, TC1-1-13M+, BD1222J50200AHF или TC4-19LN+ с Али; риск перемаркировки — первые экземпляры проверить петлёй).
3. **ПАВ L1, L5, L2 в одном корпусе** — подбор (`02-Компоненты.md`).
4. **Мощность TX1 на 2.75 ГГц** (Ф1): для HMC213 нужно +11…+13 дБм после усилителя, для LTC5510 −6…+6 дБм [ВД].
5. Фабрика и число слоёв; трафарет.
