kushpet/gnss-fe/docs/02-Компоненты.md

# Кандидаты в компоненты (черновик 2026-10-18, дополнен 2026-10-22)

Наличие и цены — по поиску 2026-10-18 и 2026-10-22; перед заказом сверять паспорт и карточку. Chip-Dip местами неоправданно дорог — для дорогих позиций смотреть AliExpress. Пометки: [ВД] паспорт, [ВИ] вторичный источник, [О] оценка.

Для своей платы v2 (2026-10-28) кандидаты, номера LCSC и наличие по снимкам страниц — `03-Плата-v2.md`, разделы 3–4.

## Смеситель: демоплаты и модули (2026-10-22)

С 2026-10-22 своё — только смеситель и платы ПАВ, предпочтительно демоплаты (`01-Требования.md`).

| Что | Порты и характеристики | Для схемы | Цена и наличие |
| --- | --- | --- | --- |
| **DC1983A** (LTC5510, «High Frequency») | вход 30–3000 МГц, гетеродин 5–6000 МГц, выход 1200–2100 МГц; при выходе 1575 МГц усиление 1.1–1.5 дБ, Кш 11.6–12.1 дБ, OIP3 24.5–27.8 дБм; вход → выход > 22 дБ (1150–3000 МГц), утечка гетеродина на выход < −33 дБм, на вход < −50 дБм [ВД, демо-мануал] | B — как есть | DigiKey €131.94, нет на складе, 10 недель [ВИ]; в Chip-Dip была в каталоге (2026-10-18) — цену проверить |
| **DC1984A** (LTC5510, «Low Frequency») | вход 30–2600 МГц, выход 10–1300 МГц, трансформатор TC4-19LN+ [ВД, паспорт LTC5510 rev. A, табл. 6] | A | Mouser (Индия) ₹32 149, 4 шт. [ВИ] |
| **Модуль HMC213 с SMA** (лот вместе с HMC175/HMC219/HMC412) | HMC213B: RF и гетеродин 1.5–4.5 ГГц, ПЧ 0–1.5 ГГц, гетеродин +9…+15 дБм, потери ~10.5 дБ на ПЧ 1.2 ГГц при +13 дБм [ВД, паспорт rev. 0, рис. 56] | A и B; **основной кандидат** — нужен усилитель гетеродина | ~$18–20 [ВИ, поиск 2026-10-22] |
| Модуль ADL5350 «demo board» 0–4 ГГц | вход и ПЧ на общем узле, разводятся LC-контурами под конкретные частоты [ВД, паспорт rev. A] | **нет**: 1176 и 1575 МГц LC-контурами без подстройки не развести [О] | доставка ~$6 [ВИ] |
| Модули ADE-1/6/11/12 | гетеродин до ~2 ГГц [ВИ] | **нет** | — |
| Модуль «10M to 6GHz Active Frequency Mixer» (ADL5801) | ПЧ ADL5801 — до 600 МГц, внешним согласованием до 3000 МГц [ВД, паспорт rev. F]; трансформатор ПЧ модуля неизвестен | A или B, только если трансформатор ПЧ на 1.2–1.6 ГГц | Fruugo ~$48, без марки [ВИ]; искать на Али, смотреть фото |

Китайских смесителей своих марок с отладочными платами не нашлось: дистрибьюторы объявляют «pin-to-pin» замены HMC213 без марок и паспортов [ВИ, поиск 2026-10-22].

Усилитель гетеродина и МШУ-модуль для HMC213: модули на SPF5189Z (50–4000 МГц; 11.9 дБ на 2.2 ГГц, P1dB +22.7 дБм на 1.96 ГГц [ВД, по выдержкам паспорта DS110606]; на 2.75 ГГц ожидаем 9–10 дБ [О]; снят с производства — модули могут быть на перемаркированных микросхемах; у SatNOGS измерено усиление на ~1 дБ ниже паспорта [ВИ]). Цена модуля — несколько долларов [не пров.].

Трансформаторы и балуны для своей платы по схеме демоплаты [ВД, паспорт LTC5510]: вход — Mini-Circuits TC1-1-13M+ (1:1); выход под 1575 МГц — Anaren BD1222J50200AHF (4:1) с 6.8 нГн × 2 и 6.8 пФ; выход под 1176 МГц — Mini-Circuits TC4-19LN+ (4:1) с 15 нГн × 2. Наличие на AliExpress не проверено.

## Готовые фильтры с SMA (2026-10-22)

| Что | Параметры | Цена, доставка |
| --- | --- | --- |
| GPIO Labs, L1 1575.42 с проходом постоянного тока | 1575 ± 7.5 МГц, 2.7 дБ; ≥ 40 дБ на 1500 МГц, ≥ 45 дБ на 1615 МГц [ВИ, Tindie] | $69; России в списке стран нет |
| GPIO Labs, L5 1176 | 1176 ± 10 МГц, < 4 дБ; ≥ 35 дБ на 1500–3000 МГц [ВИ, Tindie] | $63; России в списке стран нет |

Дорого и, вероятно, недоступно — фильтры делаем сами. Модули ПАВ L1 с SMA на AliExpress, по-видимому, есть, L5 — редкость; отсюда не проверить (поисковик Али не индексирует).

## Фильтры LTCC Mini-Circuits (2026-10-22, основной путь)

Корпус FV1206 (3.2 × 1.6 мм): 1 — вход, 3 — выход, 2 и 4 — земля; посадочное место PL-137 [ВД]. Ставятся на готовые тестовые платы 1206 с SMA с Али (`LTCC filter test board 1206 SMA`) — посадочное место сверить с PL-137.

| Фильтр | Где | Полоса [ВД] | Подавление [ВД] |
| --- | --- | --- | --- |
| BFCN-1575+ (полосовой) | перед смесителем (схема A) | 1530–1620 МГц, 2.0 дБ тип., 3.0 макс. | 47 дБ на 1150 МГц, 39 на 1050, 20 на 2220, 23.5 на 2400, 37.8 на 3100 |
| LFCN-1575+ (ФНЧ) | после смесителя (A и B) | DC–1575 МГц; 0.36 дБ на 1000, 0.76 на 1575 | 35 дБ на 2200, 37 на 2700, 41 на 4000 МГц |
| HFCN-2275+ (ФВЧ) | тракт гетеродина, по желанию | 2640–6230 МГц, ~1 дБ | 45 дБ на 1400 МГц, 24 на 1770 |
| LFCG-1575+ (ФНЧ, корпус 0805 GE0805C) | вместо LFCN-1575+, если нужен глубже | DC–1575 МГц, 0.9 дБ | ≥ 40 дБ (50 тип.) на 2400–7000 МГц; на LCSC — C4989936 [ВИ] |

Полосового LTCC Mini-Circuits на L5 (1176 МГц) не нашлось (BFCN-1160/1172/1180/1200/1220 — нет таких паспортов на сайте) [поиск 2026-10-22]. Для схемы B — SAW-модуль с Али `SAW bandpass filter SMA 1145-1253MHz GNSS` (подавление на 1575 МГц у продавца не указано) [ВИ].

## Фильтры ПАВ

| Полоса | Кандидат | Параметры | Где |
| --- | --- | --- | --- |
| L1/E1/B1/G1 | Murata SAFFB1G56KB0F0A | 1559–1606 МГц, 0.9–1.9 дБ [ВИ, everythingrf; паспорт не найден] | Chip-Dip, ~29 руб. от 10 шт. |
| L1 | EPCOS B39162-B9417 | полоса 2 МГц, только GPS C/A [ВИ] — **для E1/B1C не годится** | Chip-Dip |
| L5/E5a/B2a | Abracon AFII-SW-0060 | 1.4 × 1.1 мм, 1.4 дБ, > 35 дБ вне полосы [ВИ, Mouser] | Mouser |
| L5 | Qorvo QPQ1062 | 1176.45 МГц, полоса 31 МГц, 1.2 дБ, 1.4 × 1.2 мм [ВИ, RFMW] | RFMW |
| L5 | Huaying NDFH059-1176SA | 1.1 × 0.9 мм [ВИ, LCSC C5158023] | LCSC |
| L2 / G2 | — | не искали | — |
| диплексер 1.2 ГГц / 1559–1606 | Qualcomm B39162B4391P810 | вместо делителя L1/L5, меньше потерь [ВИ, Richardson] | наличие неизвестно |

В Chip-Dip ПАВ на 1176 МГц не найдены [пров. поиском].

## МШУ

С 2026-10-22 на платах не нужны при антенне 38 ± 2 дБ (`calc/budget.py`). Оставлены на случай антенны 28 дБ.

| Полоса | Кандидат | Параметры | Где |
| --- | --- | --- | --- |
| L5, ПЧ 1176 | Infineon BGA855N6 | 1164–1300 МГц, 17.8 дБ, Кш 0.6 дБ, 4.8 мА, 1.1–3.3 В, IIP3 0 дБм, TSNP-6 [ВД, паспорт rev. 2.0] | Chip-Dip, ~65 руб., от 6 шт. |
| L1 | Infineon BGA524N6 | 1550–1615 МГц [ВИ] | в Chip-Dip только отладочная плата; искать на Али |

## Смеситель (RF 1575 МГц, гетеродин 2752 МГц, ПЧ 1176 МГц)

| Кандидат | Тип | Диапазоны | Гетеродин | Усиление / Кш | Где |
| --- | --- | --- | --- | --- | --- |
| **LTC5510** | активный, 5 В | вход 30–3000 МГц (50 Ом), LO 5–6000 МГц, выход 1 МГц–6 ГГц (демоплаты 1.2–2.1 и 0.01–1.3 ГГц) [ВИ] | −6…+6 дБм [ВИ] | +1.5 дБ / 11.6 дБ на 1575 МГц [ВИ, ADI] | Chip-Dip — только демоплата DC1983A; чип искать на Али |
| HMC213B | пассивный ДБС, MSOP-8 | RF и LO 1.5–4.5 ГГц, ПЧ 0–1.5 ГГц [ВИ] | +13 дБм — нужен усилитель гетеродина | −10 дБ / ~10 дБ [ВИ] | Farnell; отечественный аналог К1324ПС10У в Chip-Dip — 31 500 руб. |
| ADL5801 | активный | RF и LO 10 МГц–6 ГГц [ВД]; ПЧ — открытый коллектор на 200 Ом, на 1176 МГц нужен трансформатор согласования [ВИ] | — | +1.8 / 9.8 дБ [ВИ, карточка Chip-Dip] | Chip-Dip 3850 руб. — дорого |
| Mini-Circuits ADE-11X+, ADE-12MH | пассивный | гетеродин до 2 ГГц [ВИ] — **не подходят** для 2.75 ГГц | — | — | Chip-Dip |

Предварительно [О]: LTC5510 — гетеродин напрямую от TX1 (если TX1 даёт ≥ −6 дБм на 2.75 ГГц), 50-омный вход, МШУ после смесителя не нужен (`calc/budget.py`). Окончательно — после замера мощности TX1 (Ф1).

## Источники

- BGA855N6: паспорт Infineon rev. 2.0, копия Chip-Dip static.chipdip.ru/lib/637/DOC011637188.pdf; карточки Chip-Dip 8024039580, 8010678035.
- Murata SAFFB1G56KB0F0A: everythingrf.com/products/rf-band-pass-filters/murata/521-365-saffb1g56kb0f0a; карточка Chip-Dip 8017589181.
- AFII-SW-0060: mouser.lt/datasheet/3/184/1/AFII_SW_0060.pdf; QPQ1062: rfmw.com/products/detail/qpq1062-qorvo/687845; NDFH059-1176SA: LCSC C5158023.
- B39162B4391P810: shop.richardsonrfpd.com.
- LTC5510: analog.com/en/products/ltc5510.html, демоплата DC1983A (mouser.com/datasheet/2/609/dc1983af-1269129.pdf).
- HMC213B: shop.richardsonrfpd.com/Products/Product/HMC213BMS8E, farnell 4034060.
- ADL5801: analog.com/en/products/adl5801.html (паспорт rev. F), everythingrf 539-29-adl5801; карточка Chip-Dip 8048099563.
- Состав группировки GPS: CGSIC 2026 (`iono-gnss/docs/papers/2026_gps-status_cgsic.pdf`).
- Демоплаты LTC5510: демо-мануал DC1983A (analog.com, user-guides/dc1983af.pdf), паспорт LTC5510 rev. A (5510fa.pdf, рис. 1–2, табл. 4–6); DigiKey DC1983A №4890581; Mouser DC1984A (поиск 2026-10-22). Копии паспортов — `iono-gnss/docs/papers/specs/`.
- ADL5801: паспорт rev. F (analog.com, data-sheets/adl5801.pdf); модуль — fruugo (поиск 2026-10-22).
- GPIO Labs: tindie.com/products/gpio/1575-mhz-gps-l1-band-pass-filter-with-dc-bypass, tindie.com/products/gpio/1176-mhz-gps-l5-band-pass-filter.
- HMC213B: паспорт rev. 0 (analog.com, data-sheets/hmc213B.pdf); ADL5350: паспорт rev. A (data-sheets/ADL5350.pdf) — копии в `iono-gnss/docs/papers/specs/`. Лоты Али HMC213 и ADL5350 — по поиску 2026-10-22. SPF5189Z: паспорт RFMD DS110606 (выдержки по поиску), wiki.satnogs.org/SPF5189_LNA_measurements.
- Mini-Circuits BFCN-1575+, LFCN-1575+, HFCN-2275+, LFCG-1575+: minicircuits.com/pdfs/<марка>.pdf (копии первых трёх — `iono-gnss/docs/papers/specs/`).
