kushpet/gnss-fe/kicad/A_power.kicad_sch

## KiCad design kicad/A_power.kicad_sch (2026-11-08)

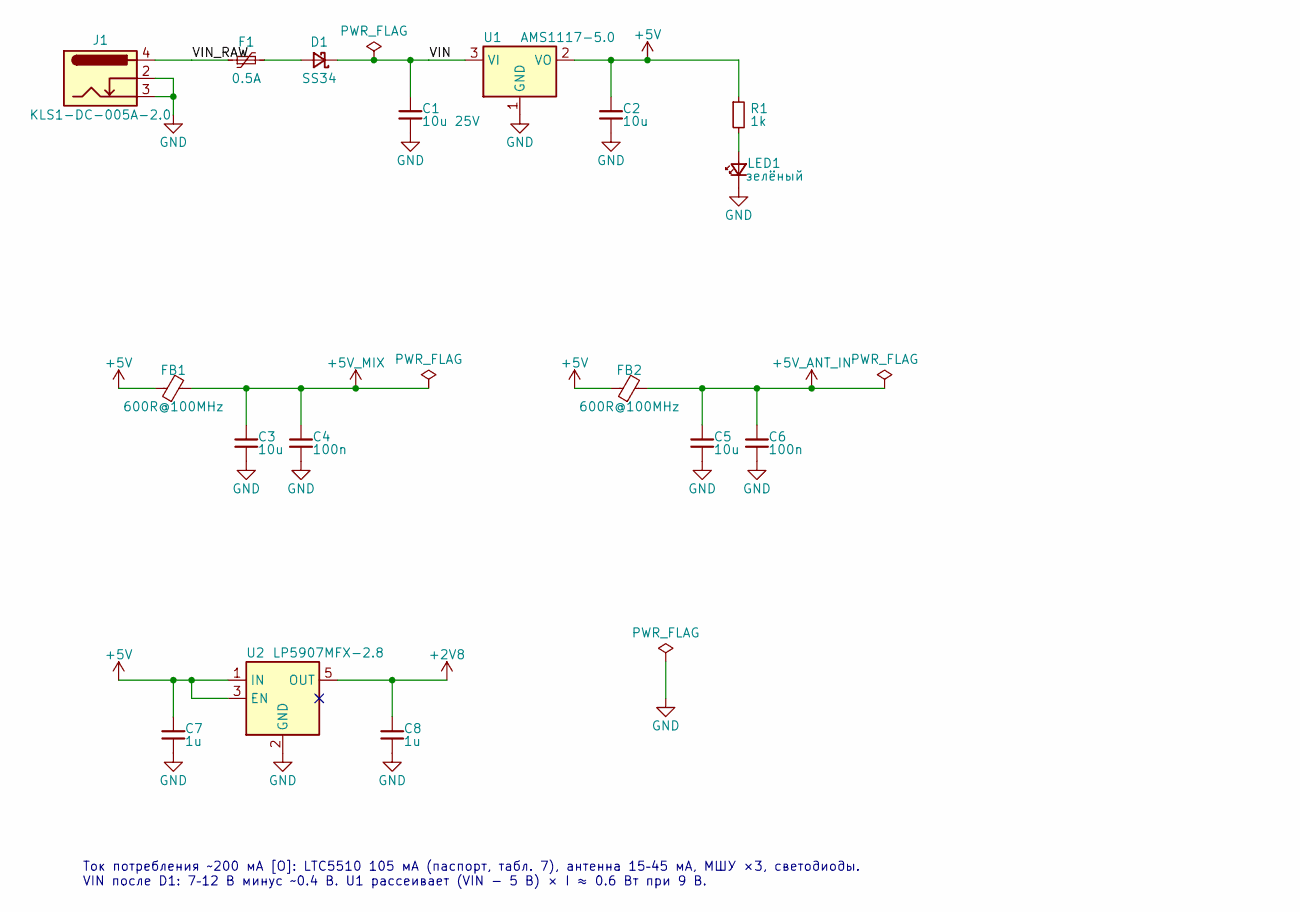
[picture p1: schematic A_power.kicad_sch]

Parts:
C1: 10u 25V; C_0805_2012Metric
C2, C3, C5: 10u; C_0805_2012Metric
C4, C6: 100n; C_0402_1005Metric
C7, C8: 1u; C_0402_1005Metric
D1: SS34; D_SMA
F1: 0.5A; Fuse_1206_3216Metric
FB1, FB2: 600R@100MHz; L_0603_1608Metric
J1: KLS1-DC-005A-2.0; KLS1-DC-005A
LED1: зелёный; LED_0603_1608Metric
R1: 1k; R_0603_1608Metric
U1: AMS1117-5.0; SOT-223-3_TabPin2
U2: LP5907MFX-2.8; SOT-23-5

Connections:
+2V8: C8.1, U2.5 (OUT)
+5V: C2.1, C7.1, FB1.1, FB2.1, R1.1, U1.2 (VO), U2.1 (IN), U2.3 (EN)
+5V_ANT_IN: C5.1, C6.1, FB2.2
+5V_MIX: C3.1, C4.1, FB1.2
GND: C1.2, C2.2, C3.2, C4.2, C5.2, C6.2, C7.2, C8.2, J1.2, J1.3, LED1.1 (K), U1.1 (GND), U2.2 (GND)
unnamed: D1.2 (A), F1.2
unnamed: LED1.2 (A), R1.2
VIN: C1.1, D1.1 (K), U1.3 (VI)
VIN_RAW: F1.1, J1.4

Notes on the sheet:
Ток потребления ~200 мА [О]: LTC5510 105 мА (паспорт, табл. 7), антенна 15–45 мА, МШУ ×3, светодиоды. VIN после D1: 7–12 В минус ~0.4 В. U1 рассеивает (VIN − 5 В) × I ≈ 0.6 Вт при 9 В.
