kushpet/gnss-fe/kicad/B_antenna.kicad_sch

## KiCad design kicad/B_antenna.kicad_sch (2026-11-08)

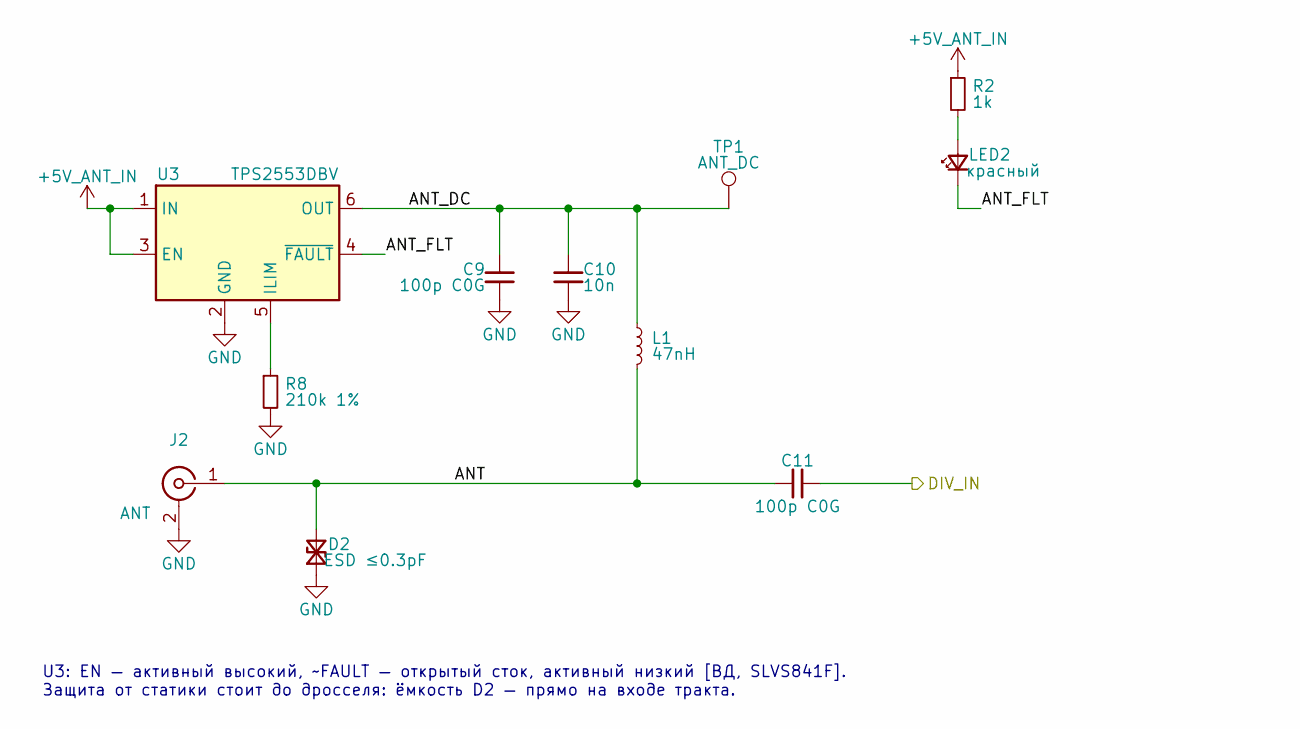
[picture p2: schematic B_antenna.kicad_sch]

Parts:
C9, C11: 100p C0G; C_0402_1005Metric
C10: 10n; C_0402_1005Metric
D2: ESD ≤0.3pF; D_0402_1005Metric
J2: ANT; SMA_Amphenol_132289_EdgeMount
L1: 47nH; L_0402_1005Metric
LED2: красный; LED_0603_1608Metric
R2: 1k; R_0603_1608Metric
R8: 210k 1%; R_0402_1005Metric
TP1: ANT_DC; TestPoint_Pad_D1.0mm
U3: TPS2553DBV; SOT-23-6

Connections:
+5V_ANT_IN: R2.1, U3.1 (IN), U3.3 (EN)
ANT: C11.1, D2.2 (A2), J2.1 (In), L1.2
ANT_DC: C9.1, C10.1, L1.1, TP1.1, U3.6 (OUT)
ANT_FLT: LED2.1 (K), U3.4 (~FAULT)
DIV_IN: C11.2
GND: C9.2, C10.2, D2.1 (A1), J2.2 (Ext), R8.2, U3.2 (GND)
unnamed: LED2.2 (A), R2.2
unnamed: R8.1, U3.5 (ILIM)

Notes on the sheet:
U3: EN — активный высокий, ~FAULT — открытый сток, активный низкий [ВД, SLVS841F]. Защита от статики стоит до дросселя: ёмкость D2 — прямо на входе тракта.
