kushpet/gnss-fe/kicad/C_divider.kicad_sch

## KiCad design kicad/C_divider.kicad_sch (2026-11-08)

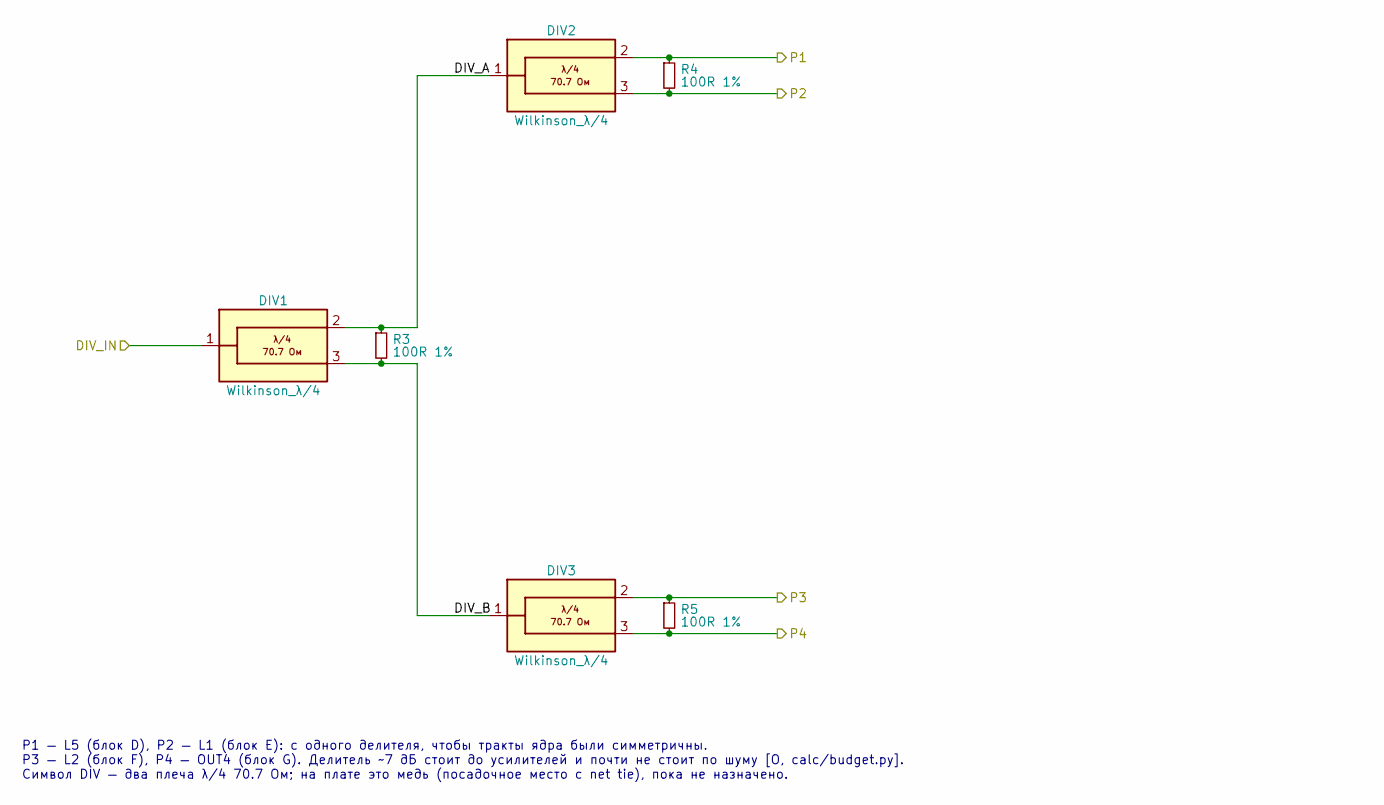
[picture p3: schematic C_divider.kicad_sch]

Parts:
DIV1, DIV2, DIV3: Wilkinson_λ/4
R3, R4, R5: 100R 1%; R_0402_1005Metric

Connections:
DIV_A: DIV1.2 (O1), DIV2.1 (IN), R3.1
DIV_B: DIV1.3 (O2), DIV3.1 (IN), R3.2
DIV_IN: DIV1.1 (IN)
P1: DIV2.2 (O1), R4.1
P2: DIV2.3 (O2), R4.2
P3: DIV3.2 (O1), R5.1
P4: DIV3.3 (O2), R5.2

Notes on the sheet:
P1 — L5 (блок D), P2 — L1 (блок E): с одного делителя, чтобы тракты ядра были симметричны. P3 — L2 (блок F), P4 — OUT4 (блок G). Делитель ~7 дБ стоит до усилителей и почти не стоит по шуму [О, calc/budget.py]. Символ DIV — два плеча λ/4 70.7 Ом; на плате это медь (посадочное место с net tie), пока 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
