kushpet/gnss-fe/kicad/D_L5.kicad_sch

## KiCad design kicad/D_L5.kicad_sch (2026-11-08)

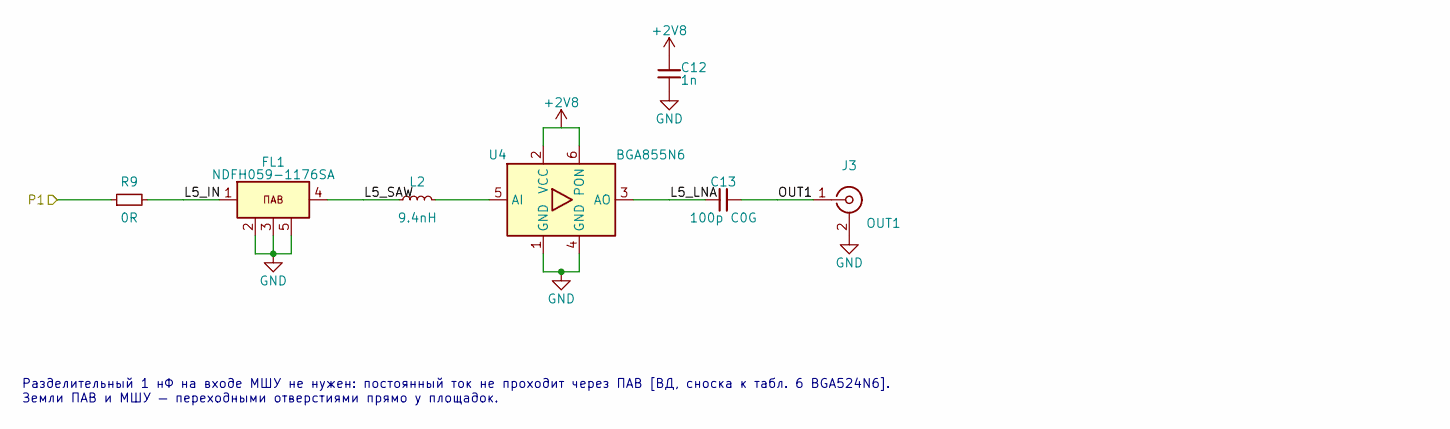
[picture p4: schematic D_L5.kicad_sch]

Parts:
C12: 1n; C_0402_1005Metric
C13: 100p C0G; C_0402_1005Metric
FL1: NDFH059-1176SA; SAW_Huaying_1.1x0.9mm_5pin; LCSC C5158023
J3: OUT1; SMA_Amphenol_132289_EdgeMount
L2: 9.4nH; L_0402_1005Metric
R9: 0R; R_0402_1005Metric
U4: BGA855N6; Infineon_TSNP-6-10_0.7x1.1mm_P0.4mm

Connections:
+2V8: C12.1, U4.2 (VCC), U4.6 (PON)
GND: C12.2, FL1.2 (GND), FL1.3 (GND), FL1.5 (GND), J3.2 (Ext), U4.1 (GND), U4.4 (GND)
L5_IN: FL1.1 (IN), R9.2
L5_LNA: C13.1, U4.3 (AO)
L5_SAW: FL1.4 (OUT), L2.1
unnamed: L2.2, U4.5 (AI)
OUT1: C13.2, J3.1 (In)
P1: R9.1

Notes on the sheet:
Разделительный 1 нФ на входе МШУ не нужен: постоянный ток не проходит через ПАВ [ВД, сноска к табл. 6 BGA524N6]. Земли ПАВ и МШУ — переходными отверстиями прямо у площадок.
