kushpet/gnss-fe/kicad/E_L1_mixer.kicad_sch

## KiCad design kicad/E_L1_mixer.kicad_sch (2026-11-08)

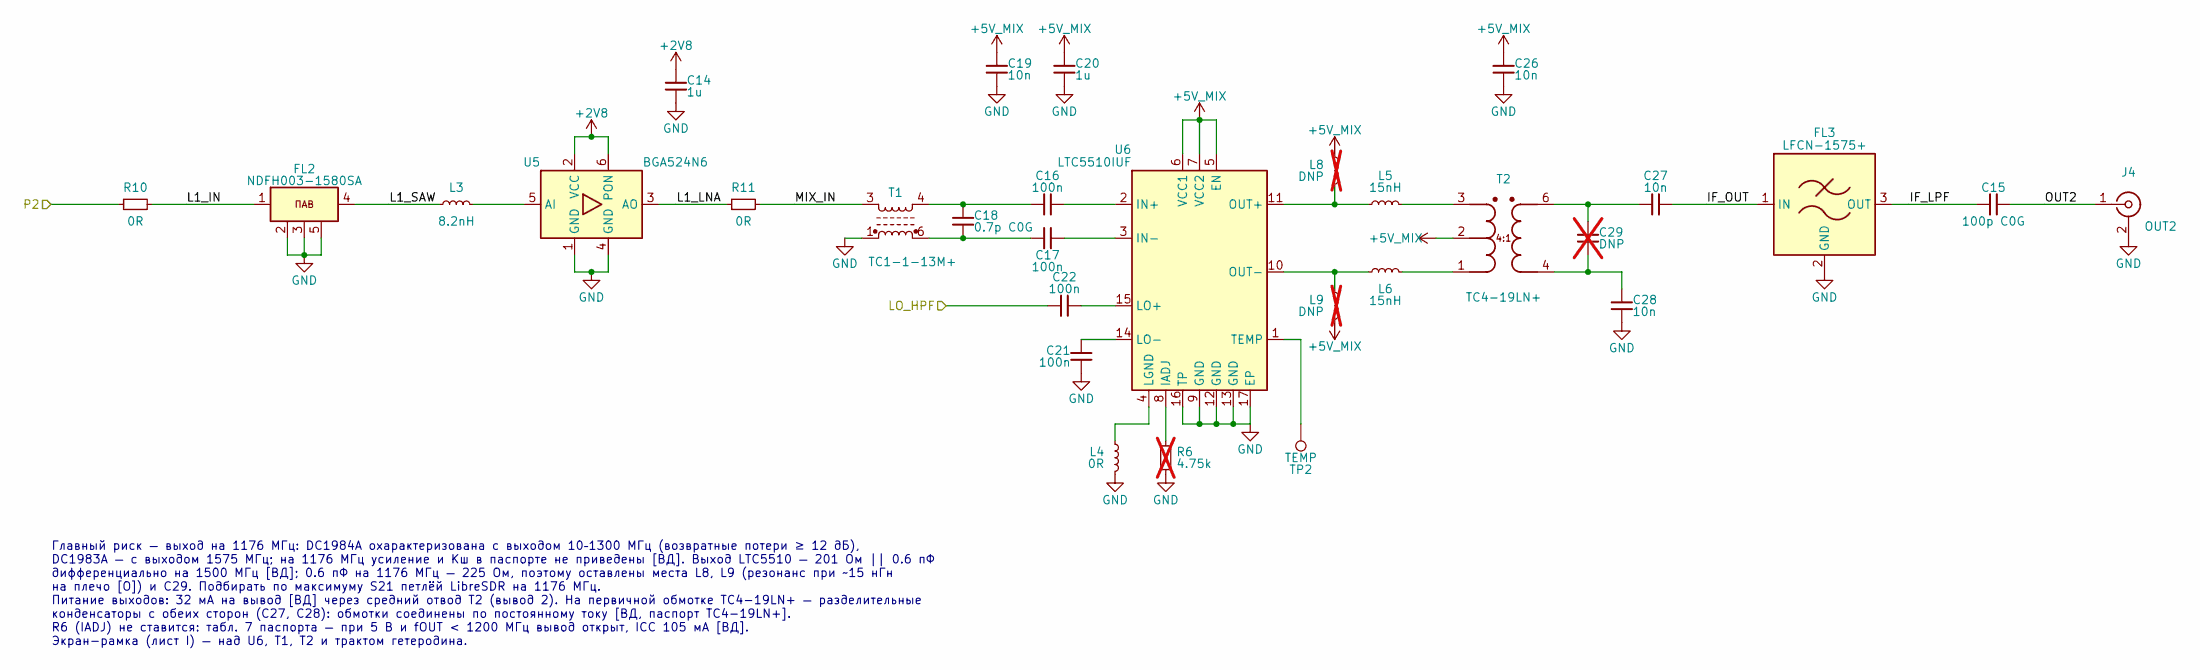
[picture p5: schematic E_L1_mixer.kicad_sch]

Parts:
C14: 1u; C_0402_1005Metric
C15: 100p C0G; C_0402_1005Metric
C16, C17, C21, C22: 100n; C_0402_1005Metric
C18: 0.7p C0G; C_0402_1005Metric
C19, C26, C27, C28: 10n; C_0402_1005Metric
C20: 1u; C_0603_1608Metric
C29: DNP; C_0402_1005Metric; not fitted
FL2: NDFH003-1580SA; SAW_Huaying_1.1x0.9mm_5pin; LCSC C312141
FL3: LFCN-1575+; Filter_Mini-Circuits_FV1206
J4: OUT2; SMA_Amphenol_132289_EdgeMount
L3: 8.2nH; L_0402_1005Metric
L4: 0R; L_0603_1608Metric
L5, L6: 15nH; L_0402_1005Metric
L8, L9: DNP; L_0603_1608Metric; not fitted
R6: 4.75k; R_0402_1005Metric; not fitted
R10, R11: 0R; R_0402_1005Metric
T1: TC1-1-13M+; Transformer_MiniCircuits_AT224-1A
T2: TC4-19LN+; Transformer_MiniCircuits_AT224-1A
TP2: TEMP; TestPoint_Pad_D1.0mm
U5: BGA524N6; Infineon_TSNP-6-10_0.7x1.1mm_P0.4mm; LCSC C6752883
U6: LTC5510IUF; QFN-16-1EP_4x4mm_P0.65mm_EP2.15x2.15mm_ThermalVias; LCSC C459909

Connections:
+2V8: C14.1, U5.2 (VCC), U5.6 (PON)
+5V_MIX: C19.1, C20.1, C26.1, L8.1, L9.2, T2.2 (CT), U6.5 (EN), U6.6 (VCC1), U6.7 (VCC2)
GND: C14.2, C19.2, C20.2, C21.2, C26.2, C28.2, FL2.2 (GND), FL2.3 (GND), FL2.5 (GND), FL3.2 (GND), FL3.4 (GND), J4.2 (Ext), L4.2, R6.2, T1.1, U5.1 (GND), U5.4 (GND), U6.9 (GND), U6.12 (GND), U6.13 (GND), U6.16 (TP), U6.17 (EP)
IF_LPF: C15.1, FL3.3 (OUT)
IF_OUT: C27.2, FL3.1 (IN)
L1_IN: FL2.1 (IN), R10.2
L1_LNA: R11.1, U5.3 (AO)
L1_SAW: FL2.4 (OUT), L3.1
LO_HPF: C22.1
MIX_IN: R11.2, T1.3
unnamed: C16.1, C18.1, T1.4
unnamed: C16.2, U6.2 (IN+)
unnamed: C17.1, C18.2, T1.6
unnamed: C17.2, U6.3 (IN-)
unnamed: C21.1, U6.14 (LO-)
unnamed: C22.2, U6.15 (LO+)
unnamed: C27.1, C29.1, T2.6
unnamed: C28.1, C29.2, T2.4
unnamed: L3.2, U5.5 (AI)
unnamed: L4.1, U6.4 (LGND)
unnamed: L5.1, L8.2, U6.11 (OUT+)
unnamed: L5.2, T2.3 (S)
unnamed: L6.1, L9.1, U6.10 (OUT-)
unnamed: L6.2, T2.1 (S)
unnamed: R6.1, U6.8 (IADJ)
unnamed: TP2.1, U6.1 (TEMP)
OUT2: C15.2, J4.1 (In)
P2: R10.1

Notes on the sheet:
Главный риск — выход на 1176 МГц: DC1984A охарактеризована с выходом 10–1300 МГц (возвратные потери ≥ 12 дБ), DC1983A — с выходом 1575 МГц; на 1176 МГц усиление и Кш в паспорте не приведены [ВД]. Выход LTC5510 — 201 Ом || 0.6 пФ дифференциально на 1500 МГц [ВД]; 0.6 пФ на 1176 МГц — 225 Ом, поэтому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
