kushpet/gnss-fe/kicad/F_L2.kicad_sch

## KiCad design kicad/F_L2.kicad_sch (2026-11-08)

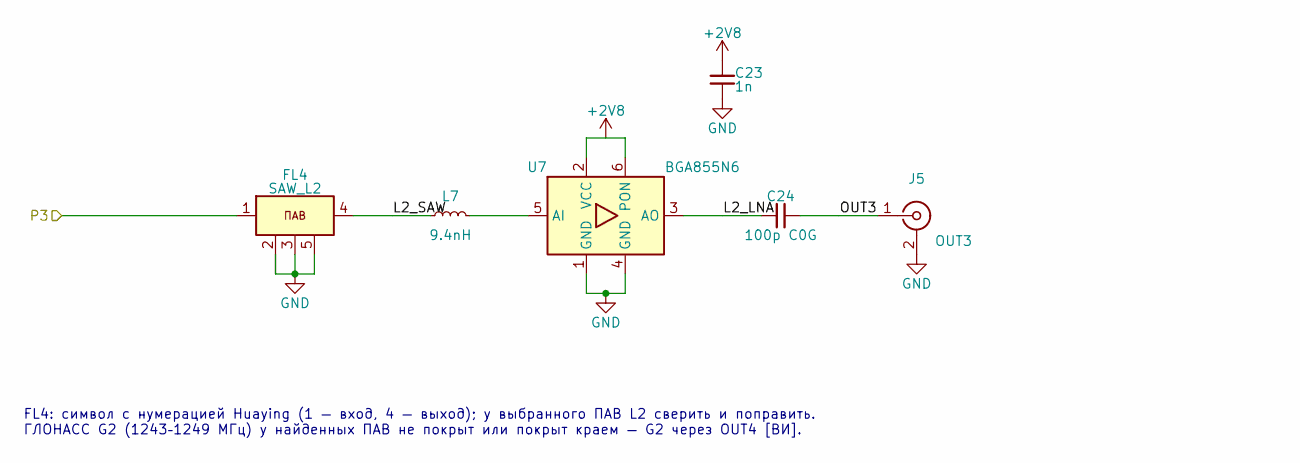
[picture p6: schematic F_L2.kicad_sch]

Parts:
C23: 1n; C_0402_1005Metric
C24: 100p C0G; C_0402_1005Metric
FL4: SAW_L2
J5: OUT3; SMA_Amphenol_132289_EdgeMount
L7: 9.4nH; L_0402_1005Metric
U7: BGA855N6; Infineon_TSNP-6-10_0.7x1.1mm_P0.4mm

Connections:
+2V8: C23.1, U7.2 (VCC), U7.6 (PON)
GND: C23.2, FL4.2 (GND), FL4.3 (GND), FL4.5 (GND), J5.2 (Ext), U7.1 (GND), U7.4 (GND)
L2_LNA: C24.1, U7.3 (AO)
L2_SAW: FL4.4 (OUT), L7.1
unnamed: L7.2, U7.5 (AI)
OUT3: C24.2, J5.1 (In)
P3: FL4.1 (IN)

Notes on the sheet:
FL4: символ с нумерацией Huaying (1 — вход, 4 — выход); у выбранного ПАВ L2 сверить и поправить. ГЛОНАСС G2 (1243–1249 МГц) у найденных ПАВ не покрыт или покрыт краем — G2 через OUT4 [ВИ].
