kushpet/gnss-fe/kicad/G_OUT4.kicad_sch

## KiCad design kicad/G_OUT4.kicad_sch (2026-11-08)

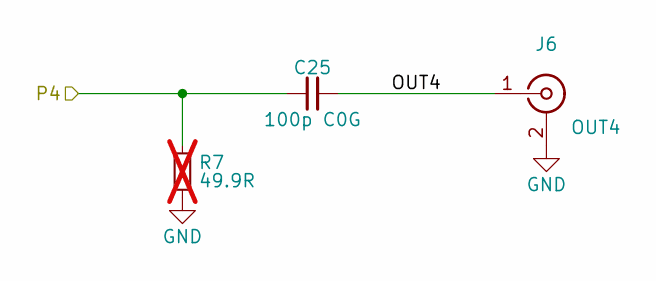
[picture p7: schematic G_OUT4.kicad_sch]

Parts:
C25: 100p C0G; C_0402_1005Metric
J6: OUT4; SMA_Amphenol_132289_EdgeMount
R7: 49.9R; R_0402_1005Metric; not fitted

Connections:
GND: J6.2 (Ext), R7.2
OUT4: C25.2, J6.1 (In)
P4: C25.1, R7.1
