kushpet/gnss-fe/kicad/H_LO.kicad_sch

## KiCad design kicad/H_LO.kicad_sch (2026-11-08)

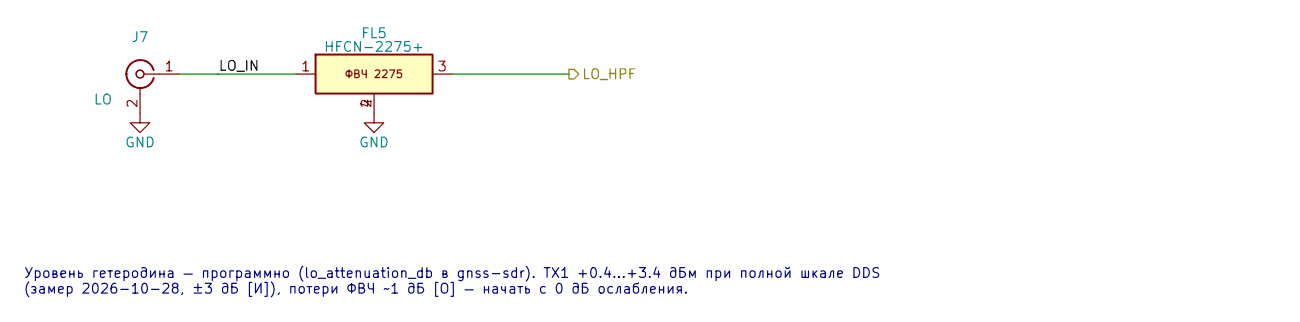
[picture p8: schematic H_LO.kicad_sch]

Parts:
FL5: HFCN-2275+; Filter_Mini-Circuits_FV1206
J7: LO; SMA_Amphenol_132289_EdgeMount

Connections:
GND: FL5.2 (GND), FL5.4 (GND), J7.2 (Ext)
LO_HPF: FL5.3 (OUT)
LO_IN: FL5.1 (IN), J7.1 (In)

Notes on the sheet:
Уровень гетеродина — программно (lo_attenuation_db в gnss-sdr). TX1 +0.4…+3.4 дБм при полной шкале DDS (замер 2026-10-28, ±3 дБ [И]), потери ФВЧ ~1 дБ [О] — начать с 0 дБ ослабления.
