kushpet/gnss-fe/(commit log)

2026-10-18 Начало: требования, кандидаты в компоненты, расчёт шума и паразитов смесителя
2026-10-22 Новый состав: смеситель и универсальная плата ПАВ вместо платы фронтенда; budget.py — модули, схема B, прямой проход, исправлен перебор откликов
2026-10-22 Основной кандидат смесителя — модуль HMC213 с усилителем гетеродина и МШУ-модулем; расчёт тракта с HMC213
2026-10-22 Фильтры — LTCC Mini-Circuits на тестовых платах с Али; схема A с HMC213 в расчёте
2026-10-22 Первая фаза: готовые модули ПАВ и ФНЧ с Али, SPF5189Z — МШУ и усилитель гетеродина
2026-10-28 budget.py: набор 2026-10-28 — антенна 28 дБ, сплиттер 1→2, SPF5189Z перед HMC213
2026-10-28 Решение: схема A (L5 напрямую, L1 через HMC213); схема в README, подключение и предельные мощности HMC213
2026-10-28 Своя плата v2: один вход, три выхода, гетеродин, питание — docs/03-Плата-v2.md, бюджет в budget.py
2026-10-28 Плата v2: LTC5510 по замеру TX1, питание 7–12 В, OUT3 — L2 и OUT4 — широкая полоса, бюджет; черновик схемы docs/04
2026-10-28 Гнездо питания KLS1-DC-005A-2.0: выводы, посадочное место, высота над платой
2026-11-08 Игнор-файлы: герберы, экспорт, бэкапы и лок-файлы KiCad; из .clineignore убран *.kicad_sym (исходник)
2026-11-08 Проект KiCad платы v2 (листы A–I, символы, посадочные, gen_sch.py) и его описание в docs/04, README, CLAUDE.md
    [A_power.kicad_sch, B_antenna.kicad_sch, C_divider.kicad_sch, D_L5.kicad_sch, E_L1_mixer.kicad_sch, F_L2.kicad_sch, G_OUT4.kicad_sch, H_LO.kicad_sch]
2026-11-08 Переписка с Резонит: письмо о стеке 4-слойной платы и заказе прототипа
